sinara-hw/Line_trigger/README.md

# Line_trigger
Low jitter 50Hz/60Hz 230V/110V mains trigger box

## Design Files

Design files (schematics, PCB layouts, BOMs) can be found at [Line_trigger/Releases](https://github.com/sinara-hw/Line_trigger/releases).

## Wiki

More information can be found on the [wiki](https://github.com/sinara-hw/Line_trigger/wiki).
