sinara-hw/Line_trigger/(list of files, drawings)

Other design files:
Line_trigger.PCBDOC
Line_trigger.PrjPcb
Line_trigger.schdoc
Panel/Panel_Line_Trigger_4HP.PcbDoc
Panel/Panel_Line_Trigger_Front.PcbDoc
