sinara-hw/Line_trigger/(threads)

Thread 1 (2020-09-16):

Form Factor

dtcallcock, 2020-09-16:
For things like this in a standalone box, can you make it a reasonable HP high and then sell optional 'ears' so that it can go in a Eurocard crate? Like how they make a lot of IT equipment 1U high so you can buy ears to mount it in a 19" rack:

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

Another idea would be just adding this functionality to [3U PSU](https://github.com/sinara-hw/meta/issues/47).  Once you have access to the mains and DC power, the extra components to implement a line trigger are pretty trivial right (like a couple $ on the BOM)?  Then everyone has a convenient line trigger if/when they ever need it.

gkasprow, 2020-09-16:
3U psu uses SMPS. We need standard isolation transformer, but it wont fit. Even the smallest one.We can make optocoupler version or make high impedance mains divider directly. I will try to fit in in the new release.

gkasprow, 2020-09-16:
The easiest way to go is to make a 1U panel with cutout to which the standard Hammond box is attached. The product can be delivered with both panels so the user can choose which one to attach.

hartytp, 2020-09-16:
My feeling is that making this rack mount is way overkill. I was thinking of something more like an extruded enclosure the size of thermostat.

hartytp, 2020-09-16:
(or, at least as small as the 50Hz transformer allows)

dtcallcock, 2020-09-16:
>The easiest way to go is to make a 1U panel with cutout to which the standard Hammond box is attached.

>making this rack mount is way overkill

Sorry, I meant using the same 'ears' idea to mount it in a Eurocard subrack.

> an extruded enclosure the size of thermostat.

Here's another idea.  Use an 24V [ac-ac plug transformer](https://www.jameco.com/c/AC/AC-Power-Supplies.html) to power the board.  The you don't need a bulky transformer or mains connector on the board, and it can be open.  From there you can copy thermostat mechanics (optional for Eurocard or standalone).

> 3U psu uses SMPS.

Ok, I forgot this.  Perhaps this isn't a great idea then.

hartytp, 2020-09-16:
> Use an 24V ac-ac plug transformer to power the board.
> From there you can copy thermostat mechanics (options for Eurocard or standalone).

That's a nice idea.

gkasprow, 2020-09-16:
Yes, and we will provide compatibility with 110, 230, and other voltages. The filter can support 50 and 60Hz at once.

hartytp, 2020-09-16:
Since this is a low frequency design can we have FP dip switches for frequency/filter bandwidth selection?

gkasprow, 2020-09-16:
Yes, we can do that. No need to put it on the FP because we will need at least 8 dip switches and once set, never touch again.

dtcallcock, 2020-09-16:
Worth using a connector that's incompatible with the standard 12V DC barrel used throughout Sinara to prevent mixups?

gkasprow, 2020-09-16:
Ye, I was thinking about it. 2.1mm one won't let you plug 12V AC to Kasli (it has 2.5mm one), but will let you plug DC PSU to the trigger box, but nothing will happen.

dhslichter, 2020-09-17:
I think you want a small metal box which can basically be installed inline on a mains power line (IEC on both sides?  Then someone can use a double-ended IEC cable to adapt out, we ship with such a cable), and have an isolated SMA or BNC on the side with the trigger output.

hartytp, 2020-09-18:
> I think you want a small plastic box which can basically be installed inline on a mains power line (IEC on both sides? Then someone can use a double-ended IEC cable to adapt out, we ship with such a cable), and have an isolated SMA or BNC on the side with the trigger output.

The advantage of an AC/AC adapter as suggested by @dtcallcock is not having to worry about mains safety, which does seem like a good idea.

I also wouldn't bother having an IEC on both sides as putting this inline with another powered device seems like a waste of time (mains sockets aren't that precious!).

hartytp, 2020-09-18:
> but something that looks like a wall wart power supply but has an isolated SMA coming out for line trigger info would be a cute little product.

If I understood @dtcallcock's proposal correctly, it's not quite that. Rather, it's a small enclosure that takes in ~9V AC (50/60Hz) from a wall wart (barrel connector that's incompatible with the one used on Kasli et al.) and has a out a couple of SMA/MCX/whatever outputs.

dhslichter, 2020-09-18:
why break it into two components like that?

gkasprow, 2020-09-18:
- safety
- support for 110 and 230V

Thread 2 (2020-09-16):

filter design

gkasprow, 2020-09-16:
This is the proposed filter design
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

and the response including tolerances
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

jordens, 2020-09-16:
I don't want to spoil the fun, but isn't this overkill?
Assuming some reasonable limit on the stability (and thus bandwidth) of any realistic mains-synchronized signal that is to be canceled, of let's say 1e-2 or maybe even 1e-3, then shouldn't a simple pair of zeners and a resistor hotwired into a mains plug be sufficient? https://www.onsemi.com/pub/Collateral/AND9282-D.PDF We have isolation in the digital inputs, this wouldn't need power supplies, any special case, mounting brackets, filter design.

gkasprow, 2020-09-16:
This would be true if the mains was ideal sinusoid. In fact, it is often heavily distorted, both by missing PFC in SMPS and triac dimmers. That's why ot provide low jitter, it's good to filter the main component and then feed the comparator.
I wouldn't connect the digital inputs to mains due to safety. touching the BNC can be lethal hazard. The simplest aproach would be just an optocoupler fed by the mains signal with Zener and resistor.

jordens, 2020-09-16:
That distortion and its variability is precisely the limit in cancelling a mains cycle effect and feeding forward such a cancellation signal. What's the point in timing with respect to the fundamental if your feed forward signal has high harmonic content? I can see how being very narrowband will actually decrease robustness/stability to changes in the distortion.

gkasprow, 2020-09-16:
that's good question. Long time ago I saw such circuit somewhere at CERN, but they used flyeheel generator, so that could make sense...

jordens, 2020-09-16:
The PS rotating machine may well benefit from this ;)

gkasprow, 2020-09-16:
What I can do, is to add a jumper that selects the signal from before the filter or after the filter. In this way we can easily compare if that makes any sense.

hartytp, 2020-09-16:
> That distortion and its variability is precisely the limit in cancelling a mains cycle effect and feeding forward such a cancellation signal. What's the point in timing with respect to the fundamental if your feed forward signal has high harmonic content? I can see how being very narrowband will actually decrease robustness/stability to changes in the distortion.

yes, the optimal solution here depends on the application. But, having something that can remove the higher frequency in the noise is cheap to implement and useful in at least some cases.

@gkasprow can we use the same OpAmp as Zotino here? Low cost, low power consumption and better component reuse between designs (we must be buying in ku now with Fastino/Zotino?). Maybe also have a passive RF filter before the OpAmps to remove out-of-bandwidth signals?

hartytp, 2020-09-16:
what are those big output capacitors?

gkasprow, 2020-09-16:
> what are those big output capacitors?
oh, this is a reference generation circuit. The schematic was generated by ADI tool
Sure, we can reuse opamps from Zotino, but in this case, even the cheapest LM324 will do the job.

gkasprow, 2020-09-19:
@hartytp Take a quick look at this schematic
Supply
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
filter + comparator
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

Making the circuit 50/60Hz would require placing 8 switches + 8 caps. I think the existing circuit will work for 60Hz as well. If somebody wants, one can install 27nF caps instead of 33nF ones or order such a version.

Initial placement
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

dtcallcock, 2020-09-21:
> I think the existing circuit will work for 60Hz as well.

How about just centering the BPF at 55Hz?

gkasprow, 2020-09-22:
30nF capacitors would do that. You simply order 60Hz/110V version and you get it with right capacitors and AC adapter

Closed 2020-09-22.

Thread 3 (2020-09-20):

schematic issues

hartytp, 2020-09-20:
looking at https://github.com/sinara-hw/Line_trigger/issues/2#issuecomment-695365925

- [x] IC1 requires a NR capacitor for stability. 1uF recommended
- [x] confirm voltage ratings on LDO input/output capacitors (e.g. IC1 recommends 47uF on the output, we have 2x22uF which could end up being a lot lower under bias depending on the selected capacitor type). Similarly, the input requires a min of 10uF. We have 22uF but that could wind up marginal once bias is taken into account. Same goes for the negative LDO (e.g. is the FB capacitor large enough under bias?)
- [x] worth having a CMC/line filter on the input?
- [x] why is there a reverse bias diode on the output of the negative LDO and not the positive? I'd put one on both to be safe
- [x] isn't 680Ohm a bit on the low side for driving LEDs from 5V?
- [x] negative LDO NR recommendation is 1uF
- [x] negative LDO output capacitor recommendation is 47uF (under bias)
- [x] the schematic annotation says 1W max for the input power. Surely we can't use anything close to that can we???
- [x] for the negative LDO we might as well stick with their feedback resistor choices to ensure the RC poles are where the IC designers want them

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

I'm not going to look at the active filter topology / component selection in detail. The transfer function you posted looked sensible.

- [x] were we planning to have a DIP switch/(solder?) jumper to allow the filter to be bypassed?
- [x] should we add a small feedback capacitor on the comparator to help stabilize it (the slew rate on the input is quite low so may lead to instability) and give nice sharp edges? This is a very fast comparator so I'd worry about oscillations when driven by a 50Hz signal...
- [x] can you add a suitable AC/AC adaptor with the right connector to the schematic/BOM so we make sure all users use the same part (less work to debug than if everyone picks their own!)
- [x] SN74LVT125 is recommended for 3V3 max operation
- [x] the output buffer has to drive a 100Ohm load so might be wroth a tantalum capacitor by it..

Otherwise, looks good to me! Let's get it made :)

hartytp, 2020-09-20:
Maybe add a schematic annotation/design variant for 60Hz?

gkasprow, 2020-09-20:
if we load both outputs with 50Ohm, we end up with 1W
The comparator already has hysteresis, I added a DNP capacitor
Right, I meant LV125 which works at 5V and is capable of driving 100Ohm loads.
I added a 47uF cap to the output buffer supply + FB. Not worth increasing the BOM with a tantalum cap.

hartytp, 2020-09-20:
@gkasprow Aren’t there already tantalum caps after the rectifier (not that it matters, I’m happy either way).

It’s 500mW max isn’t it since it’s 2.5V AC into 100 ohm in two channels?

hartytp, 2020-09-20:
Anyway I’m happy to move to manufacture when you are.

Thanks for the nice work on this :)

gkasprow, 2020-09-20:
Yes, 500mW dissipates on the load. Add the LDO efficiency :)

hartytp, 2020-09-20:
Oops!

gkasprow, 2020-09-20:
Oh, OK, I asumed permanent state H. Of course we have 50% duty cycle.

hartytp, 2020-09-21:
For anyone following: the plan is to get TS to produce a batch shortly. Contact Greg/Pawel if you're interested...

dtcallcock, 2020-09-21:
> the plan is to get TS to produce a batch shortly

Will you post a final design for review or do you need to get this off yesterday (not a huge deal but always good to have more eyes)?

>can you add a suitable AC/AC adaptor with the right connector to the schematic/BOM so we make sure all users use the same part (less work to debug than if everyone picks their own!)

Good idea but you need one for each region.  [This one](http://catalog.triadmagnetics.com/Asset/WAU12-200.pdf) looks readily available in the US.  It has a 2.1x5.5mm plug as suggested.  It's 11mm long - does that length work?

I've definitely seen those wall wart transformers put out higher than specified voltage under light load.  Looks like the regs can take 36V which should be plenty, but might be worth selecting caps with a similar rating if you didn't already.

gkasprow, 2020-09-21:
the schematics are in the repo

hartytp, 2020-09-21:
> Will you post a final design for review or do you need to get this off yesterday (not a huge deal but always good to have more eyes)?

There is no mad rush, but I need to keep things moving through my to do list for sanity's sake...

> I've definitely seen those wall wart transformers put out higher than specified voltage under light load. Looks like the regs can take 36V which should be plenty, but might be worth selecting caps with a similar rating if you didn't already.

Yes, good point. @gkasprow are you happy that the OpAmp circuit will still function happily if the voltage comes out a bit high?

dtcallcock, 2020-09-22:
>Good idea but you need one for each region. This one looks readily available in the US. It has a 2.1x5.5mm plug as suggested. It's 11mm long - does that length work?

The [722RA](http://www.switchcraft.com/Product.aspx?ID=7049) you are using mates with the [S760](http://www.switchcraft.com/Product.aspx?ID=2588) which is 9.5mm long, so this will work.

> the schematics are in the repo

Does IC8 need a 10nF decoupling cap? Other than that, I didn't see anything else.

gkasprow, 2020-09-22:
we don't want the voltage to rise to 35V - the LDOs won't dissipate that much of power. Let's keep the capacitors as they are now.

Closed 2020-09-22.

Thread 4 (2020-09-23):

Adaptors

dtcallcock, 2020-09-23:
EU version uses [77DE-06-09](https://www.idealpower.co.uk/wp-content/uploads/2017/07/ideal-power-9v-ac-0.67a-euro-psu-77de-06-09-a1.pdf), 9V, 10W supply.
US version uses [WAU12-200](https://catalog.triadmagnetics.com/Asset/WAU12-200.pdf), 12V, 4W supply.

Should they both be 9V to reduce the debugging space?  Closest US part looks like [WAU090-1200](https://catalog.triadmagnetics.com/Asset/WAU090-1200.pdf) 9V, 12W.

gkasprow, 2020-09-23:
It could be even 6V one.

cjbe, 2020-12-17:
The equivalent UK plug version is 77DB-06-09, 9V, 10W supply. (eg Farnell 2368014)

hartytp, 2021-11-02:
@gkasprow the jack on the line trigger board is the same one as on Kasli. IIRC we agreed that we would use a non-compatible one people accidentally mixing up ac and dc supplies.

NB the PSU on the schematic is not compatible with the jack on the PCB. Shall we change the PCB to match (and not match Kasli?)

Thread 5 (2021-02-04):

Wiki: Input voltage Range 9-12 V RMS?

pathfinder49, 2021-02-04:
Looking through the wiki the input voltage range does not specify what the 9-12 V input range refers to. Is this RMS, amplitude, or peak to peak? It would be nice to clarify this.

gkasprow, 2021-02-04:
in the case of AC, we usually specify the RMS value.

pathfinder49, 2021-02-04:
Thanks :) I've just set up one of these in the lab and would like to add a couple of things to the wiki. If you'd like to give me editing rights, I'll add this while I'm at it.

gkasprow, 2021-02-04:
done

pathfinder49, 2021-02-05:
Thanks Greg :) However, the editing rights don't seem to have worked. I still can't edit the Line_trigger wiki.

gkasprow, 2021-02-05:
oh, I gave rights to the wrong pathfinder :)

Closed 2021-02-06.
