sinara-hw/Line_trigger/(commit log)

2020-09-20 schematics & PCB ready, initial panel design
    [Line_trigger.PCBDOC, Line_trigger.PrjPcb, Line_trigger.schdoc, Panel_Line_Trigger_4HP.PcbDoc, Panel_Line_Trigger_Front.PcbDoc]
2020-09-22 v1.0 rc1
    [Line_trigger.PCBDOC, Line_trigger.PrjPcb, Line_trigger.schdoc]
